mrnuke/osciboost-hardware/osciboost.sch

## KiCad design osciboost.sch (2013-01-27)

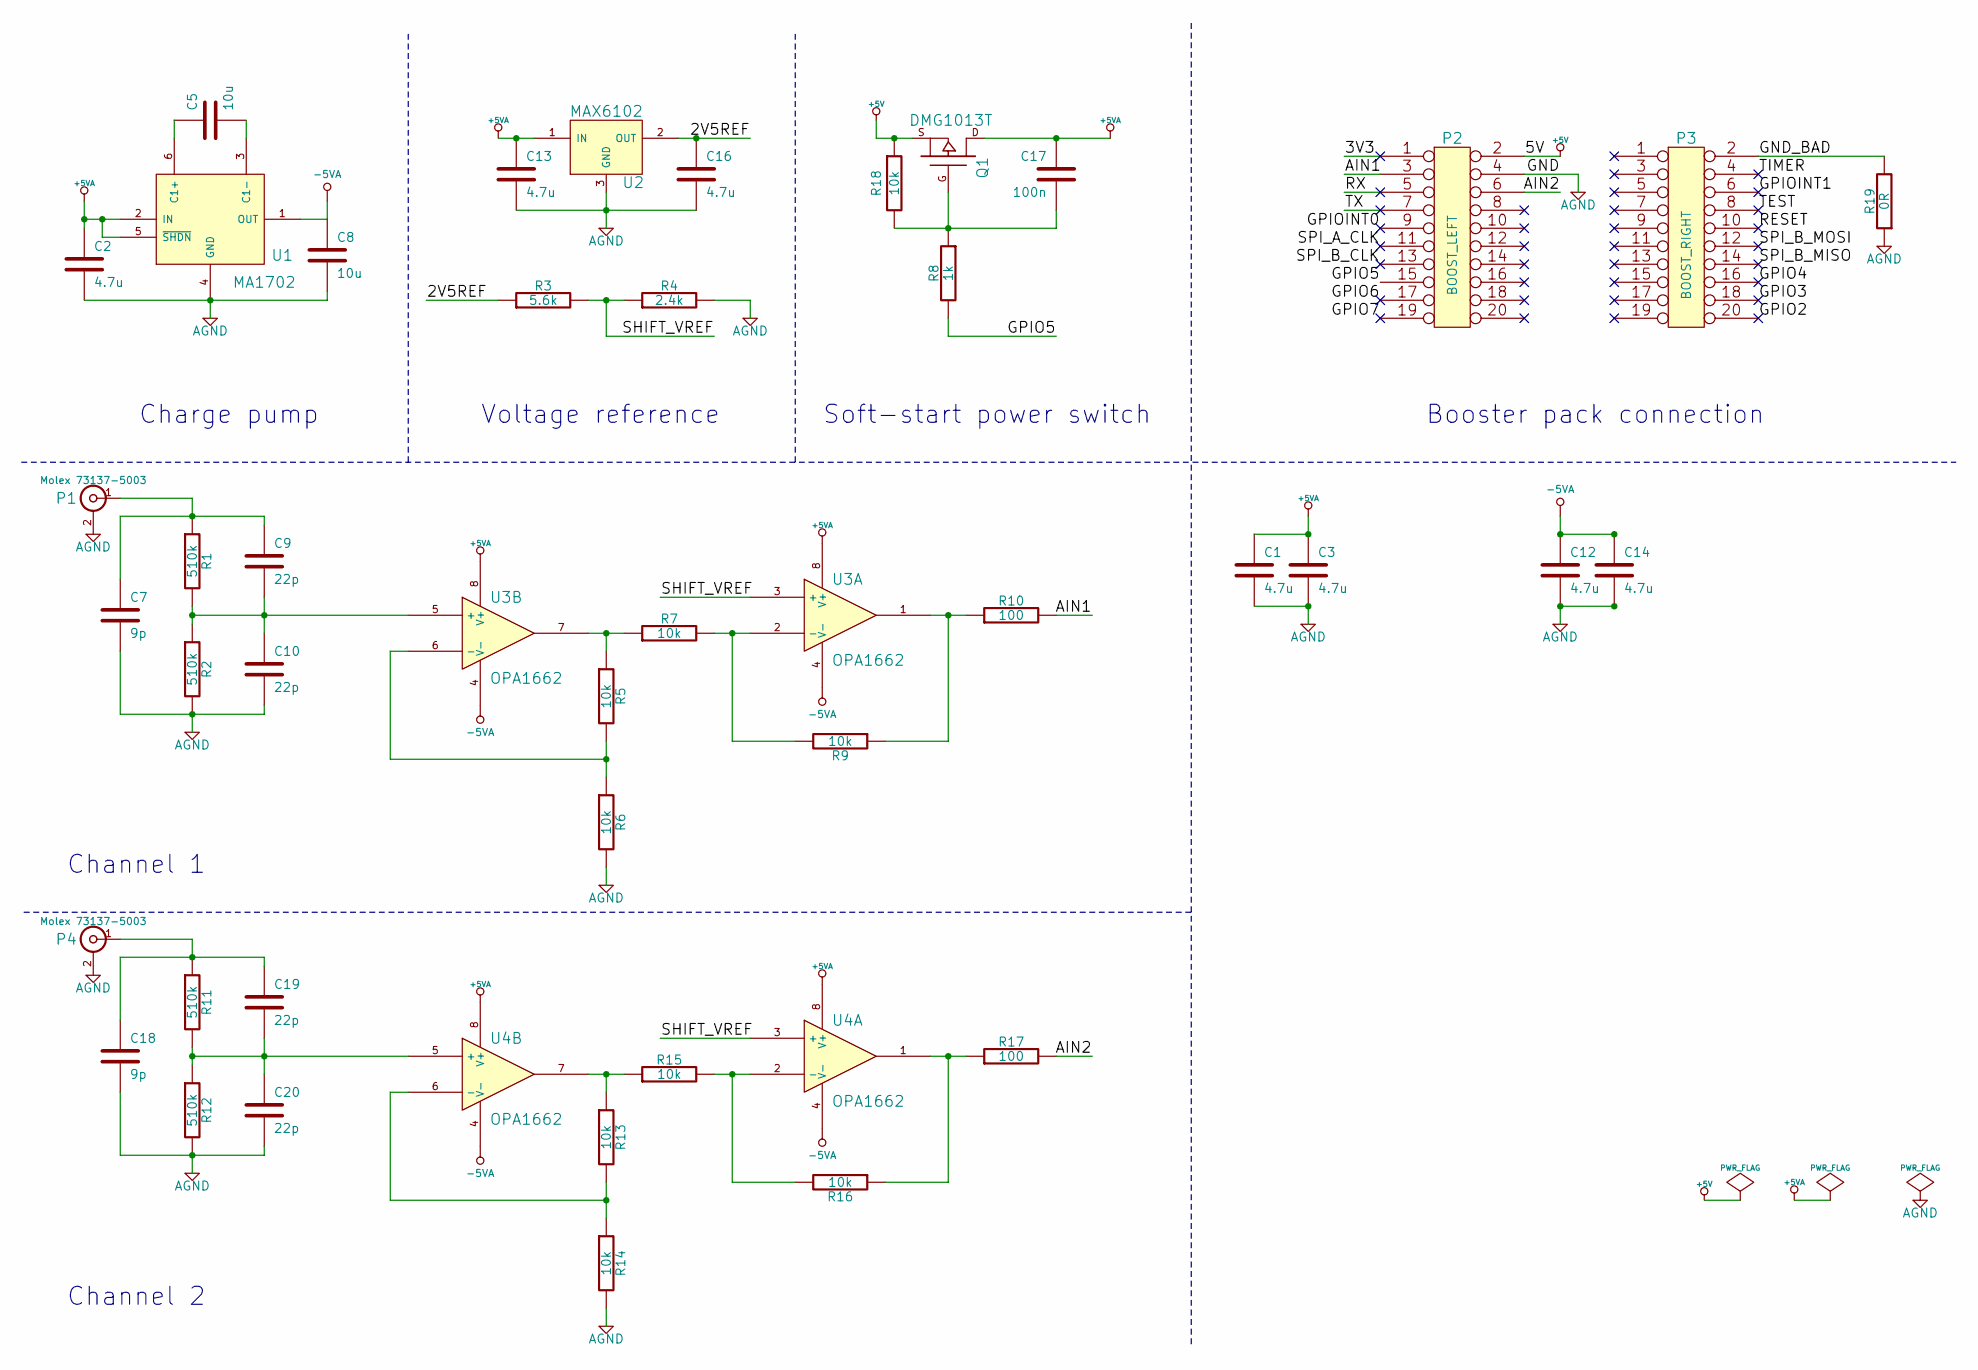
[picture p1: schematic osciboost.sch]

Parts:
C1, C2, C3, C12, C13, C14, C16: 4.7u
C5, C8: 10u
C7, C18: 9p
C9, C10, C19, C20: 22p
C17: 100n
P1, P4: Molex 73137-5003
P2: BOOST_LEFT
P3: BOOST_RIGHT
Q1: DMG1013T
R1, R2, R11, R12: 510k
R3: 5.6k
R4: 2.4k
R5, R6, R7, R9, R13, R14, R15, R16, R18: 10k
R8: 1k
R10, R17: 100
R19: 0R
U1: MA1702
U2: MAX6102
U3, U4: OPA1662

Connections:
2V5REF: C16.1, R3.1, U2.2 (OUT)
3V3: P2.1
+5V: P2.2, Q1.S, R18.1
+5VA: C1.1, C2.1, C3.1, C13.1, C17.1, Q1.D, U1.2 (IN), U1.5 (~SHDN), U2.1 (IN), U3.8 (V+), U4.8 (V+)
-5VA: C8.1, C12.1, C14.1, U1.1 (OUT), U3.4 (V-), U4.4 (V-)
AGND: C1.2, C2.2, C3.2, C7.2, C8.2, C10.2, C12.2, C13.2, C14.2, C16.2, C18.2, C20.2, P1.2 (Ext), P2.4, P4.2 (Ext), R2.2, R4.2, R6.2, R12.2, R14.2, R19.1, U1.4 (GND), U2.3 (GND)
AIN1: P2.3, R10.2
AIN2: P2.6, R17.2
GND_BAD: P3.2, R19.2
GPIO2: P3.20
GPIO3: P3.18
GPIO4: P3.16
GPIO5: P2.15, R8.2
GPIO6: P2.17
GPIO7: P2.19
GPIOINT0: P2.9
GPIOINT1: P3.6
unnamed: C5.1, U1.6 (C1+)
unnamed: C5.2, U1.3 (C1-)
unnamed: C7.1, C9.1, P1.1 (In), R1.1
unnamed: C9.2, C10.1, R1.2, R2.1, U3.5 (+)
unnamed: C17.2, Q1.G, R8.1, R18.2
unnamed: C18.1, C19.1, P4.1 (In), R11.1
unnamed: C19.2, C20.1, R11.2, R12.1, U4.5 (+)
unnamed: R5.1, R7.1, U3.7
unnamed: R5.2, R6.1, U3.6 (-)
unnamed: R7.2, R9.2, U3.2 (-)
unnamed: R9.1, R10.1, U3.1
unnamed: R13.1, R15.1, U4.7
unnamed: R13.2, R14.1, U4.6 (-)
unnamed: R15.2, R16.2, U4.2 (-)
unnamed: R16.1, R17.1, U4.1
RESET: P3.10
RX: P2.5
SHIFT_VREF: R3.2, R4.1, U3.3 (+), U4.3 (+)
SPI_A_CLK: P2.11
SPI_B_CLK: P2.13
SPI_B_MISO: P3.14
SPI_B_MOSI: P3.12
TEST: P3.8
TIMER: P3.4
TX: P2.7

Notes on the sheet:
Channel 2
Channel 1
Charge pump
Voltage reference
Soft-start power switch
Booster pack connection
