mrnuke/osciboost-hardware/(commit log)

2013-01-21 Initial commit: Preliminary hardware schematic
    Nothing much to say at this point.
    [osciboost.sch]
2013-01-21 Add preliminary osciboost board layout
    [osciboost.brd]
2013-01-21 Change VIA drill size to 0.3mm
    The defaultvia drill of 0.63mm is inappropriate. Most manufacturers can
    handle 0.3mm vias without a problem, so whitch the drill size to 0.3mm.
    [osciboost.brd]
2013-01-21 Chage channel 1 footprint to oaa_SOT23-3
    Channel 1 used kicad's default SOT23-3 footprint for the opamps, while Channel 2
    used the fotprint from Oyvind's (oaa) footprint library. Change channel 1
    footprints to the oaa SOT23-3 footprint for consistency.
    [osciboost.brd]
2013-01-21 Change BNC drill size from 1.00mm to 1.02mm
    Only the BNC connectors use 1.00mm holes, while the booster pack connectors use
    1.02mm holes.. Changing the BNC hole size to match the other sizes allows the
    board to be manufactured with one less drill change.
    [osciboost.brd]
2013-01-21 Move AIN1 track to top layer
    Move the AIN1 track to the top layer, and the move the adjacent GND track to the
    bottom layer.
    [osciboost.brd]
2013-01-22 Optimize power delivery and reduce number of vias
    Route the GND through the bottom layer, and the +5V and -5V power rails through
    the top rail. The number of vias is reduced from 44 to 35 (-9).
    [osciboost.brd]
2013-01-22 Fix entry angle for ground pads on filled zones
    On zones filled with copper (in our case, ground planes), tracks must come in
    through the path that the zone will connect to the pad. this means a 45 degree
    approach angle for round pads, and a vertical or horizontal approach for
    rectangular pads.
    [osciboost.brd]
2013-01-22 Add pull-up resistor for the soft-start circuit
    The microcontroller can never bring the voltage on the gate of the soft-start
    MOSFET to the 5V needed to turn off power. To only way to achieve 5V is to have
    a pull-up resistor, and let the control pin in high-impedance mode.
    When the control pin is configured as an output, and (preferrably) set low, the
    osciboost module will be powered on. To power off the module, the pin is put
    into high-impedance mode.
    Add a 10k pull-up resistor to enable the power-off circuit to function
    correctly.
    [osciboost.brd, osciboost.sch]
2013-01-22 Change OPAMP footprints to SOT353 (SC70-5)
    [osciboost.brd]
2013-01-23 Move BNC shadow from silkscreen to drawings layer
    The swadow of the BNC plug in the molex footprint was placed on the silkscreen
    layer. This caused the shadow, which is outside the PCB edges, to show up on
    the silkscreen when generating gerbers. This could potentially confuse PCB
    manufacturers.
    Move the shadow of the BNC connector from the silkscreen layer to the drawings
    layer.
    [osciboost.brd]
2013-01-23 Adjust copper fill areas
    Reduce antipad clearance to 0.3mm.
    Increase the number of segments for round pads from 16 to 32.
    [osciboost.brd]
2013-01-26 Replace OPAMP with OPA1662 in MSOP-8 package
    The previously selected opamps could only handle 6V, not the 10V we are feeding
    them. Change the opamps to OPA1662, which have the desired characteristics.
    Also, using dual opamps allows us to reduce the number of filter capacitors.
    Because the change in footprint, re-laying part of the board was also needed.
    The advantage is that the pinout of the MSOP-8 package is identical with many
    other opamps.
    [osciboost.brd, osciboost.sch]
2013-01-27 Reorganize ground planes
    Use only one ground analog plane; do not split it up in mini ground planes for
    power, reference voltage etc. The previous layout routed the ground, AIN, and
    power signals independently, creating a bunch of small antennas ready to pick up
    noise. To solve this, join the analog ground plane near the AIN pins on the
    connector, and route all signals (including power) above the join.
    Decouple the ground planes from the ground pin on the right-side connector.
    Ground currents could have leaked around the analog ground plane, through the
    GND pin, creating a large antenna. Not having a ground path through the right
    GND pin would break compatibility with 20-pin boards. To solv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
    [osciboost.brd, osciboost.sch]
2013-01-27 Cosmetic corrections before prototype run
    [osciboost.brd]
2013-01-27 rev0.1: Place revision number on sheets and board
    [osciboost.brd, osciboost.sch]
